2950685798-cpu/GestureCar/方案.md

# 手势操控小车 方案文档（V2）

> 2026-09-08 定稿。所有引脚、协议、手势定义以此文档为准。

## 1. 系统总览

```
手势端（手持裸板）                      车端（麦轮小车）
┌─────────────────────┐    NRF24L01   ┌──────────────────────────┐
│ STM32F103C8         │  50Hz 无线    │ STM32F103C8              │
│  ├─ MPU6500 (I2C2)  │ ◄───────────► │  ├─ NRF24L01 (软件SPI)      │
│  └─ NRF24L01 (软件SPI) │               │  ├─ 2×TB6612 (TIM2 PWM)  │
└─────────────────────┘               │  ├─ OLED (软件I2C)       │
                                      │  └─ 按键 PA15 (解锁/急停) │
                                      └──────────────────────────┘
```

- 工具链：STM32CubeMX + Keil MDK-ARM（两端均为 STM32F103C8）
- 电源：3S 锂电池 12V → 降压模块 5V → TB6612 VM + 蓝板 5V 脚（板上 AMS1117 出 3.3V），全部共地
  - 降压模块输出电流需 ≥2A（四轮堵转峰值 2~4A），实测确认
  - 电机额定 3-6V，**严禁 12V 直连 VM**

## 2. 车端引脚分配

| 引脚 | 功能 |
|---|---|
| PA0 | TIM2_CH1 PWM → 左 TB6612 PWMA（左前轮）  |
| PA1 | TIM2_CH2 PWM → 左 TB6612 PWMB（左后轮） |
| PA2 | TIM2_CH3 PWM → 右 TB6612 PWMA（右前轮） |
| PA3 | TIM2_CH4 PWM → 右 TB6612 PWMB（右后轮） |
| PB0 / PB1 | 左 TB6612 AIN1 / AIN2 |
| PB10 / PB11 | 左 TB6612 BIN1 / BIN2 |
| PB14 / PB15 | 右 TB6612 AIN1 / AIN2 |
| PB13 / PC15 | 右 TB6612 BIN1 / BIN2（2026-09-14 PB12 烧坏，BIN2 挪到 PC15） |
| PB8 / PB9 | OLED SCL / SDA（软件 I2C，从机地址 0x78） |
| PB6 / PB7 | 空闲（OLED 的 VCC 直接接 3.3V） |
| PA15 | 按键（内部上拉，按下接地） |
原引脚：| PA8 / PA9 / PA10 / PA11 / PA12 | NRF24L01 CE / SCK / CSN / MOSI / MISO（软件 SPI，与车端一致，IRQ 不接） |
| PA4 / PA5 / PA6 / PA7 / PA12 | NRF24L01 CE / CSN / SCK / MOSI / MISO（软件 SPI，GPIO 模拟；2026-09-13 PA8/PA9 烧坏后挪来，MISO 一直 PA12） |

- TB6612 STBY 直接接 3.3V 常使能
- TIM2 PWM：10kHz（PSC=0，ARR=7199）

## 3. 手势端引脚分配

| 引脚 | 功能 |
|---|---|
| PB10 / PB11 | MPU6500 I2C2 SCL / SDA（400kHz） |
| PA8 / PA9 / PA10 / PA11 / PA12 | NRF24L01 CE / SCK / CSN / MOSI / MISO（软件 SPI，与车端一致，IRQ 不接） |
| PB8 / PB9 | OLED 软 I2C SCL / SDA |
| PA0 | 按键（总开关）：一端接 3.3V、一端接引脚（内部下拉，按下=1）。按一下手端开始工作（采样+OLED 显示+NRF 发送），再按一下全部停止 |
| PA6 | 解锁/锁定车端的按键（接法和 PA0 相同：一端接 3.3V、内部下拉；按下连发命令 7，2026-09-14 加） |
| PA3 | 顺时针旋转指示输出（代码保留；2026-09-14 CubeMX 重生成后已不在配置里，需用时再配 GPIO_Output） |
| PC13 | 板载 LED（测试指示） |

- 不跑 DMP，直接读原始数据：加速度计反算 pitch/roll，陀螺仪 Z 轴角速度测拧腕
- 手端 OLED 只显示当前动作（2026-09-12 改：删掉 X/Y/Z/P/R 调试数字和标签，动作文字第 2 行居中；关机画面不变）。显示写入大幅减少，软 I2C 错位乱码概率随之大降

## 4. 手势定义

| 手势（手持板姿态） | 车端动作 | OLED 显示 |
|---|---|---|
| 前倾（pitch > +20°） | 前进（速度恒定） | `front` |
| 后倾（pitch < -20°） | 后退 | `back` |
| 左倾（roll > +20°） | 左平移 | `left` |
| 右倾（roll < -20°） | 右平移 | `right` |
| 左拧（yaw 角速度超阈值，正向） | 原地逆时针旋转 360° | `rotate left` |
| 右拧（yaw 角速度超阈值，负向） | 原地顺时针旋转 360° | `rotate right` |
| 放平（±20° 内） | 停止 | `stop` |
| 车端无信号（>500ms） | 先停车；持续失联 >2s 才重新锁定 | `link lost!` |

- 倾斜 ±20° 为死区阈值，速度恒定（PWM 占空比待实车标定）
- 旋转 360° 为**定时开环**：固定 PWM 转固定时间，时间常数实车标定；边沿触发，执行期间忽略重复指令
- 拧腕阈值（yaw 角速度）100°/s（2026-09-12 用户实测调整，陀螺仪原始值 ±13100）
- 旋转识别带 1 秒锁定：一次拧腕结束（角速度回到死区）后 1 秒内不再识别任何旋转，防止回正动作被误判成反向旋转（防连发）；锁定期内倾斜手势照常识别

## 5. 麦轮运动方向表（待实车验证）

"正"= 电机正转（车前进方向），"反"= 反转。平移方向依赖滚子朝向（A/B 轮），下表为通用形式，**实车测试后可能需交换平移的两行**，代码中做成常量表便于修改。

| 动作 | 左前 LF | 左后 LR | 右前 RF | 右后 RR |
|---|---|---|---|---|
| 前进 | 反 | 反 | 反 | 反 |
| 后退 | 正 | 正 | 正 | 正 |
| 左平移 | 正 | 反 | 反 | 正 |
| 右平移 | 反 | 正 | 正 | 反 |
| 顺时针原地转 | 反 | 反 | 正 | 正 |
| 逆时针原地转 | 正 | 正 | 反 | 反 |

> 2026-09-13 实测整车行进方向与手势相反（电机接线极性所致），平移四行已整体取反，上表为当前生效值；2026-09-13 晚实测原地旋转方向也反，旋转两行同样互换（顺时针/逆时针两行对调）。

## 6. 通信协议（NRF24L01）

```
帧格式: [帧头 0xA5] [命令] [序号] [校验]   共 4 字节
发送频率: 约 30Hz（60Hz 采样中每 2 拍发一包；2026-09-12 由 15Hz 提到 30Hz——
          电机 EMI 压接收时帧流越密，越容易漏进干扰间隙）
模式: 增强型 ShockBurst，自动应答 + 重发，2Mbps，固定 5 字节地址
```

命令字：

| 值 | 含义 |
|---|---|
| 0x00 | STOP（放平） |
| 0x01 | FRONT（前进） |
| 0x02 | BACK（后退） |
| 0x03 | LEFT（左平移） |
| 0x04 | RIGHT（右平移） |
| 0x05 | ROT_L（逆时针 360°） |
| 0x06 | ROT_R（顺时针 360°） |
| 0x07 | 解锁/锁定切换（手端 PA6 按下时连发约 400ms，车端按上升沿去重只切一次） |

- 序号每包递增（车端据此测丢包/判重）
- 校验 = 前 3 字节累加（已定）
- 旋转：手端识别后锁 1 秒防回正误触发；车端收到旋转命令时**边沿执行**一次 360°（转完丢弃积压旧帧，防连发）
- 失联保护（2026-09-12 改两级）：车端 500ms 收不到有效包 → 立即停车（安全第一）；停车后继续失联 2s → 才重新锁定（需再按键解锁）。电机 EMI 会压死车端 NRF 接收（车一停链路就恢复），旧逻辑「失联即锁」导致每个动作做 1 秒就被锁

## 7. 按键逻辑（车端 PA15）

```
上电: 锁定（不响应任何指令），OLED 显示 Locked
按下: 解锁 → Unlocked，开始响应指令
再按: 锁定 + 立即停车（兼作急停）
```

- 按键消抖 160ms（2026-09-12 由 20~30ms 加长：电机 EMI 会干扰按键线，短消抖易误触发），按一下切换一次
- 手端 PA6 遥控解锁/锁定（2026-09-14 加）：接法和 PA0 相同（一端 3.3V、内部下拉，按下读 1），消抖 48ms；按下后连发 0x07 约 400ms（≈12 帧，丢几帧也能送到），车端按 0x07 上升沿去重只切换一次，锁定期间也生效。车端 PA15 与手端 PA6 两个键等效，断联自动上锁后可用手端直接解锁

## 8. OLED 显示布局（128×64，8×16 英文，4 行）

```
行1: GestureCar V2
行2: Locked / Unlocked
行3~4: 当前指令（上表字符串），失联时显示 link lost!
```

- 复用现有软 I2C 驱动（OLED.c / OLED_Font.h，PB8/PB9，0x78），OLED_I2C_Init 中的重复 MX_GPIO_Init 调用删除

## 9. 待实车标定参数

| 参数 | 初值 | 说明 |
|---|---|---|
| 运行 PWM 占空比 | ~100%（999） | 2026-09-13 用户自行改 999；最早 1000 曾致 MCU 复位，若复位需降回 500 以下 |
| 360° 旋转时间 | 3000ms | 2026-09-13 用户要求改 3 秒；仍待实车标定 |
| 倾斜阈值 | ±20° | 已定 |
| 拧腕角速度阈值 | ±100°/s | 已定（2026-09-12） |
| 失联超时 | 停车 500ms / 上锁 2s | 已定（2026-09-12 改两级） |

## 10. 开发顺序

1. 车端电机驱动层（TB6612 + 麦轮方向表）+ 简单自检
2. 车端 OLED + 按键逻辑（Locked/Unlocked）
3. 车端 NRF 接收 + 协议解析 + 失联保护
4. 手势端 MPU6500 读取 + 手势识别 + NRF 发送
5. 整机联调 + 参数标定（占空比、360° 时间、拧腕阈值、麦轮平移方向）

---

# 第二部分：通俗版（新手向 · 原理 / 接线 / CubeMX 配置）

## 1. 这个车是怎么工作的（大白话）

手拿一块小电路板（手势端）：

- 板子**往前倾** → 车前进；**往后倾** → 车后退
- 板子**往左歪** → 车向左平移；**往右歪** → 车向右平移
- 板子**水平放平** → 车停
- 手拿板子**快速拧一下手腕** → 车原地转 360° 后停下

过程：手势板上的 **MPU6500**（姿态传感器）测出你的手势 → 板上的 **NRF24L01**（无线模块）把命令发给车 → 车上的 NRF 收到后，车上的 STM32 控制两块 **TB6612**（电机驱动芯片）让四个麦轮转起来。车上的 **OLED 屏幕**实时显示车正要执行的动作，**按键**是安全锁。

## 2. 车端：每个引脚接什么、CubeMX 里怎么配

### 2.1 已经配好的（现在工程里就有，不用动）

| 引脚 | 接到哪里 | CubeMX 里的配置 | 干什么用 |
|---|---|---|---|
| PA0 | 左 TB6612 的 PWMA | TIM2_CH1（PWM） | 左前轮转速 |
| PA1 | 左 TB6612 的 PWMB | TIM2_CH2（PWM） | 左后轮转速 |
| PA2 | 右 TB6612 的 PWMA | TIM2_CH3（PWM） | 右前轮转速 |
| PA3 | 右 TB6612 的 PWMB | TIM2_CH4（PWM） | 右后轮转速 |
| PB0 | 左 TB6612 的 AIN1 | GPIO_Output | 左前轮方向 |
| PB1 | 左 TB6612 的 AIN2 | GPIO_Output | 左前轮方向 |
| PB10 | 左 TB6612 的 BIN1 | GPIO_Output | 左后轮方向 |
| PB11 | 左 TB6612 的 BIN2 | GPIO_Output | 左后轮方向 |
| PB14 | 右 TB6612 的 AIN1 | GPIO_Output | 右前轮方向（2026-09-11 换接线后 PB12/13 与 PB14/15 职责互换） |
| PB15 | 右 TB6612 的 AIN2 | GPIO_Output | 右前轮方向 |
| PB13 | 右 TB6612 的 BIN1 | GPIO_Output | 右后轮方向 |
| PC15 | 右 TB6612 的 BIN2 | GPIO_Output | 右后轮方向（2026-09-14 PB12 烧坏挪来；PC15 原本就是 NRF 测试 LED 输出脚，无需重新生成） |
| PB8 | OLED 的 SCL | GPIO_Output | 屏幕时钟线（软件 I2C，普通输出脚即可） |
| PB9 | OLED 的 SDA | GPIO_Output | 屏幕数据线 |

> PWM 引脚解释：PWM 就是"超快地开开关关"，开的时间占比（占空比）越大，电机平均电压越高、转得越快。方向脚 AIN1/AIN2 决定正转还是反转，PWM 脚决定快慢。

### 2.2 需要你在 CubeMX 里新加的

| 引脚 | 接到哪里 | CubeMX 里的配置 | 说明 |
|---|---|---|---|
| （无） | OLED 模块的 VCC | 直接接 3.3V | OLED 供电直接接线，不占用引脚 |
| PA15 | 按键一端（另一端接 GND） | GPIO_Input + Pull-up | 上拉：不按读 1，按下读 0。注意 SYS 的 Debug 必须选 Serial Wire，PA15 才能当普通脚用 |
| PA10 | NRF 的 CSN | GPIO_Output | 无线模块片选（初始 High，不选中） |
| PA9 | NRF 的 SCK | GPIO_Output | 无线模块时钟 |
| PA12 | NRF 的 MISO | GPIO_Input + Pull-up | 无线模块收数据 |
| PA11 | NRF 的 MOSI | GPIO_Output | 无线模块发数据 |
| PA8 | NRF 的 CE | GPIO_Output | 无线模块使能（初始 Low） |

> NRF 采用软件 SPI（GPIO 模拟），5 个脚全配成 GPIO 即可，不需要开 SPI 外设。

## 3. 手势端：每个引脚接什么（另一块板子，引脚互不影响）

| 引脚 | 接到哪里 | CubeMX 里的配置 |
|---|---|---|
| PB10 | MPU6500 的 SCL | I2C2_SCL |
| PB11 | MPU6500 的 SDA | I2C2_SDA |
| PA10 | NRF 的 CSN | GPIO_Output |
| PA9 | NRF 的 SCK | GPIO_Output |
| PA12 | NRF 的 MISO | GPIO_Input + Pull-up |
| PA11 | NRF 的 MOSI | GPIO_Output |
| PA8 | NRF 的 CE | GPIO_Output |
| 5V 脚 | 供电 | 接 5V（USB 充电宝 / 电池 + 降压模块） |

## 4. 实物接线（照着连就行）

### 4.1 电源

```
3S锂电池(12V) → 降压模块(调到5V输出) ──┬── 蓝板"5V"脚（板上自动稳压出3.3V）
                                      └── 两块 TB6612 的 VM 脚
降压模块的 GND ─────────────── 所有模块的 GND 都连在一起（共地！）
```

⚠️ **共地是必须的**：电池、降压模块、蓝板、两块 TB6612、OLED、NRF 的 GND 全部相通，不然信号对不上、车会抽风。
⚠️ **电机额定 3~6V**：降压模块必须调到 5V 再接 TB6612 的 VM，**严禁 12V 直接接 VM**。
⚠️ 降压模块电流要 ≥2A（四个轮子一起堵转时电流很大）。

### 4.2 两块 TB6612（模块上的引脚含义）

每个 TB6612 模块有一面信号脚、一面输出脚：

| 模块引脚 | 含义 | 接到哪（左模块 / 右模块） |
|---|---|---|
| PWMA | A 路转速（PWM） | PA0 / PA2 |
| AIN1、AIN2 | A 路方向 | PB0、PB1 / PB14、PB15 |
| PWMB | B 路转速（PWM） | PA1 / PA3 |
| BIN1、BIN2 | B 路方向 | PB10、PB11 / PB13、PC15 |
| STBY | 使能脚，高电平才工作 | 直接接 3.3V（常开） |
| VM | 电机电源 | 降压模块 5V |
| VCC | 芯片逻辑电源 | 3.3V |
| GND | 地 | 共地 |
| AO1、AO2 | 接 A 路电机两根线 | 左模块接**左前轮**电机 / 右模块接**右前轮** |
| BO1、BO2 | 接 B 路电机两根线 | 左模块接**左后轮**电机 / 右模块接**右后轮** |

控制逻辑（真值表，程序里就是按这个写）：

| AIN1 | AIN2 | 电机 |
|---|---|---|
| 0 | 0 | 停（自由滑行） |
| 1 | 0 | 正转 |
| 0 | 1 | 反转 |
| 1 | 1 | 刹车（急停，推荐停车用这个） |

> 电机两根线接反了不会坏，只是这个轮子方向反了——交换两根线即可。

### 4.3 OLED 四脚模块

| OLED 引脚 | 接到哪 |
|---|---|
| VCC | 直接接 3.3V |
| GND | 共地 |
| SCL | PB8 |
| SDA | PB9 |

### 4.4 NRF24L01 模块（8 脚，两端接法相同）

| NRF 引脚 | 接到哪 |
|---|---|
| VCC | **3.3V（必须！接 5V 会烧）** |
| GND | 共地 |
| CE | PA8 |
| CSN | PA10 |
| SCK | PA9 |
| MOSI | PA11 |
| MISO | PA12 |
| IRQ | 悬空不接 |

### 4.5 按键（车端）

PA15 接按键一脚，按键另一脚接 GND。不按 = 读到 1，按下 = 读到 0。

### 4.6 MPU6500 模块（手势端）

| MPU6500 模块引脚 | 接到哪 |
|---|---|
| VCC | 蓝板 **3.3V** 脚（GY-6500 板载稳压才允许接 5V，拿不准统一接 3.3V） |
| GND | 共地 |
| SCL | PB10（I2C2_SCL） |
| SDA | PB11（I2C2_SDA） |
| AD0（地址选择） | 接 GND = I2C 地址 0x68（只用一颗就接地） |
| INT（中断输出） | 悬空不接（程序轮询读数据，不用中断） |

限制/注意：

1. 芯片 VDD 上限 3.6V，**不能直接接 5V**；模块板载稳压的才允许 VCC 接 5V，拿不准就接 3.3V
2. SCL/SDA 要上拉：模块板一般自带 4.7k 上拉，CubeMX 配 I2C2 时引脚也会开内部上拉，短线够用；通信不稳再外接 4.7k 到 3.3V
3. I2C 速率配 400kHz（MPU6500 最高 400kHz），杜邦线尽量短
4. 上电后等约 100ms 再读 WHO_AM_I（寄存器 0x75，应返回 0x70），不对就是接线/地址/供电问题
5. PB10/PB11 是 5V 容忍脚，模块上拉是 5V 也不会烧板子，但统一 3.3V 最好
6. 手势端供电：蓝板 5V 脚接 USB 充电宝，板上稳压出 3.3V 同时喂 MPU6500（~4mA）和 NRF（峰值 ~13mA），够用

## 5. CubeMX 关键配置说明（车端）

1. **RCC**：HSE 选 Crystal/Ceramic Resonator，时钟树 PLL×9 → 系统时钟 72MHz
2. **SYS**：Debug 选 **Serial Wire**（不选 JTAG，PA15 才能当按键用）
3. **TIM2**：Clock Source 选 Internal Clock，Channel1~4 全部选 PWM Generation CHx；PSC=0、ARR=7199 → 频率 = 72MHz ÷ 7200 = **10kHz**；Pulse 先填 0（上电时电机不动，安全）
   - 为什么 10kHz：PWM 频率低于 1kHz 时电机会发出"滋滋"声，10kHz 人耳听不见
4. **GPIO 输出**：PB0、PB1、PB10~PB15、PB8、PB9 全部 Output Push-Pull
5. **GPIO 输入**：PA15 设 Input + Pull-up

## 6. 手势是怎么测出来的（通俗版）

- MPU6500 里有两个传感器：**加速度计**（测倾斜——重力方向随板子倾斜而变，算出 pitch/roll 两个角）和**陀螺仪**（测角速度——转多快）
- 前/后倾、左/右倾看加速度计的 pitch/roll；**拧手腕**看陀螺仪 Z 轴的角速度（拧得越快数值越大）
- ±20° 是"死区"：倾斜不够 20° 就认为没做手势，这样手轻微抖不会误触发
- 只有"拧腕"是触发式（拧一下 → 车转 360° 就停），其他手势是"保持式"（一直倾斜就一直走，放平就停）

## 7. 常见坑（先看一遍，少走弯路）

1. NRF 接 5V 必烧，只能 3.3V
2. 忘了共地 → 各种玄学问题
3. OLED 不亮：检查 VCC 是否接了 3.3V、SCL/SDA 是否接反（SCL 必须接 PB8）
4. **TB6612 的 VM 误接 12V（实测故障，2026-09-12）**：电机额定 3-6V，12V 灌入瞬间电流暴涨 → 电池电压被拉垮 → 降压模块输出掉 → 车端 3.3V 不稳 → NRF/蓝板复位。表现为"车一执行动作，OLED 就跳回 LOCKED/STOP，电机也不转"。VM 必须接降压模块 5V 输出
5. 电机不转：检查 TB6612 的 STBY 有没有接 3.3V、VM 有没有接 5V
6. 下载程序：ST-Link 接蓝板的 3.3V、SWDIO（PA13）、SWCLK（PA14）、GND
7. 第一次测试时**把车架空**（轮子悬空），防止车突然窜出去
