2950685798-cpu/GestureCar/相关资料/43c3239f1538416598892b294f0051db.png

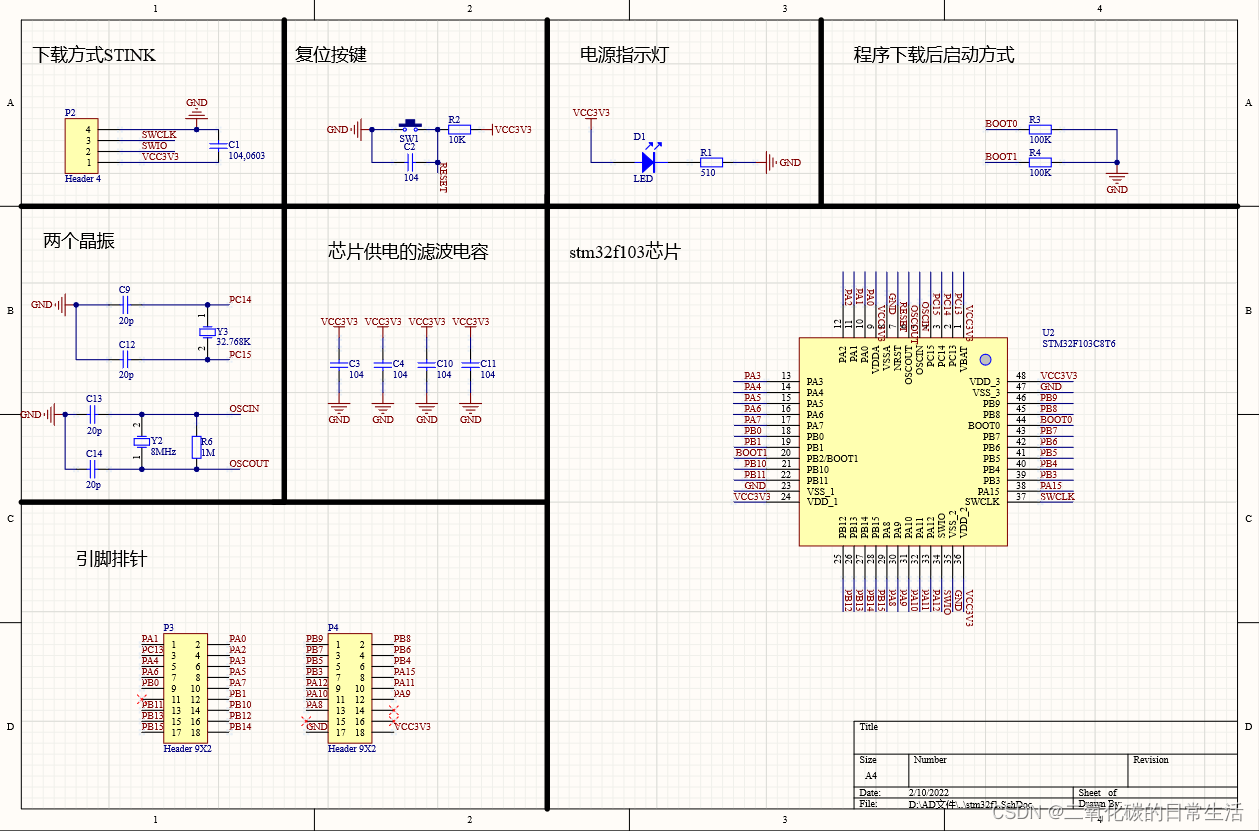
相关资料/43c3239f1538416598892b294f0051db.png
