2950685798-cpu/GestureCar/相关资料/268924_TB6612FNG.png

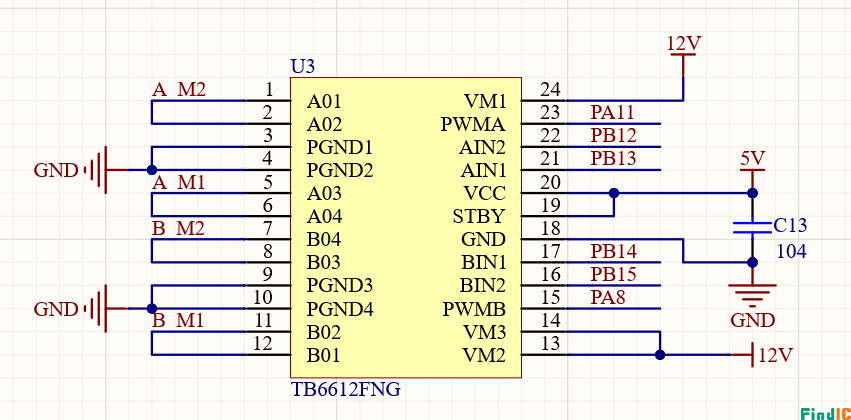
相关资料/268924_TB6612FNG.png
