2950685798-cpu/GestureCar/Car/MDK-ARM/.cmsis/device/ARM/ARMCM85/Include/Template/partition_ARMCM85.h

/**************************************************************************//**
 * @file     partition_ARMCM85.h
 * @brief    CMSIS-CORE Initial Setup for Secure / Non-Secure Zones for Armv8.1-M Mainline
 * @version  V1.0.0
 * @date     07. March 2022
 ******************************************************************************/
/*
 * Copyright (c) 2022 Arm Limited. All rights reserved.
 *
 * SPDX-License-Identifier: Apache-2.0
 *
 * Licensed under the Apache License, Version 2.0 (the License); you may
 * not use this file except in compliance with the License.
 * You may obtain a copy of the License at
 *
 * www.apache.org/licenses/LICENSE-2.0
 *
 * Unless required by applicable law or agreed to in writing, software
 * distributed under the License is distributed on an AS IS BASIS, WITHOUT
 * WARRANTIES OR CONDITIONS OF ANY KIND, either express or implied.
 * See the License for the specific language governing permissions and
 * limitations under the License.
 */

#ifndef PARTITION_ARMCM85_H
#define PARTITION_ARMCM85_H

/*
//-------- <<< Use Configuration Wizard in Context Menu >>> -----------------
*/

/*
// <e>Initialize Security Attribution Unit (SAU) CTRL register
*/
#define SAU_INIT_CTRL          1

/*
//   <q> Enable SAU
//   <i> Value for SAU->CTRL register bit ENABLE
*/
#define SAU_INIT_CTRL_ENABLE   1

/*
//   <o> When SAU is disabled
//     <0=> All Memory is Secure
//     <1=> All Memory is Non-Secure
//   <i> Value for SAU->CTRL register bit ALLNS
//   <i> When all Memory is Non-Secure (ALLNS is 1), IDAU can override memory map configuration.
*/
#define SAU_INIT_CTRL_ALLNS  0

/*
// </e>
*/

/*
// <h>Initialize Security Attribution Unit (SAU) Address Regions
// <i>SAU configuration specifies regions to be one of:
// <i> - Secure and Non-Secure Callable
// <i> - Non-Secure
// <i>Note: All memory regions not configured by SAU are Secure
*/
#define SAU_REGIONS_MAX   8                 /* Max. number of SAU regions */

/*
//   <e>Initialize SAU Region 0
//   <i> Setup SAU Region 0 memory attributes
*/
#define SAU_INIT_REGION0    1

/*
//     <s>Description
*/
#define SAU_INIT_DSCR0     "NSC code"   /* description SAU region 0 */

/*
//     <o>Start Address <0-0xFFFFFFE0>
*/
#define SAU_INIT_START0     0x00000000      /* start address of SAU region 0 */

/*
//     <o>End Address <0x1F-0xFFFFFFFF>
*/
#define SAU_INIT_END0       0x001FFFFF      /* end address of SAU region 0 */

/*
//     <o>Region is
//         <0=>Non-Secure
//         <1=>Secure, Non-Secure Callable
*/
#define SAU_INIT_NSC0       1
/*
//   </e>
*/

/*
//   <e>Initialize SAU Region 1
//   <i> Setup SAU Region 1 memory attributes
*/
#define SAU_INIT_REGION1    1

/*
//     <s>Description
*/
#define SAU_INIT_DSCR1     "NS code"   /* description SAU region 1 */

/*
//     <o>Start Address <0-0xFFFFFFE0>
*/
#define SAU_INIT_START1     0x00200000

/*
//     <o>End Address <0x1F-0xFFFFFFFF>
*/
#define SAU_INIT_END1       0x003FFFFF

/*
//     <o>Region is
//         <0=>Non-Secure
//         <1=>Secure, Non-Secure Callable
*/
#define SAU_INIT_NSC1       0
/*
//   </e>
*/

/*
//   <e>Initialize SAU Region 2
//   <i> Setup SAU Region 2 memory attributes
*/
#define SAU_INIT_REGION2    1

/*
//     <s>Description
*/
#define SAU_INIT_DSCR2     "NS data"   /* description SAU region 2 */

/*
//     <o>Start Address <0-0xFFFFFFE0>
*/
#define SAU_INIT_START2     0x20200000

/*
//     <o>End Address <0x1F-0xFFFFFFFF>
*/
#define SAU_INIT_END2       0x203FFFFF

/*
//     <o>Region is
//         <0=>Non-Secure
//         <1=>Secure, Non-Secure Callable
*/
#define SAU_INIT_NSC2       0
/*
//   </e>
*/

/*
//   <e>Initialize SAU Region 3
//   <i> Setup SAU Region 3 memory attributes
*/
#define SAU_INIT_REGION3    1

/*
//     <s>Description
*/
#define SAU_INIT_DSCR3     "NS peripherals"   /* description SAU region 3 */

/*
//     <o>Start Address <0-0xFFFFFFE0>
*/
#define SAU_INIT_START3     0x40000000

/*
//     <o>End Address <0x1F-0xFFFFFFFF>
*/
#define SAU_INIT_END3       0x40040000

/*
//     <o>Region is
//         <0=>Non-Secure
//         <1=>Secure, Non-Secure Callable
*/
#define SAU_INIT_NSC3       0
/*
//   </e>
*/

/*
//   <e>Initialize SAU Region 4
//   <i> Setup SAU Region 4 memory attributes
*/
#define SAU_INIT_REGION4    0

/*
//     <s>Description
*/
#define SAU_INIT_DSCR4     "SAU region 4"   /* description SAU region 4 */

/*
//     <o>Start Address <0-0xFFFFFFE0>
*/
#define SAU_INIT_START4     0x00000000      /* start address of SAU region 4 */

/*
//     <o>End Address <0x1F-0xFFFFFFFF>
*/
#define SAU_INIT_END4       0x00000000      /* end address of SAU region 4 */

/*
//     <o>Region is
//         <0=>Non-Secure
//         <1=>Secure, Non-Secure Callable
*/
#define SAU_INIT_NSC4       0
/*
//   </e>
*/

/*
//   <e>Initialize SAU Region 5
//   <i> Setup SAU Region 5 memory attributes
*/
#define SAU_INIT_REGION5    0

/*
//     <s>Description
*/
#define SAU_INIT_DSCR5     "SAU region 5"   /* description SAU region 5 */

/*
//     <o>Start Address <0-0xFFFFFFE0>
*/
#define SAU_INIT_START5     0x00000000

/*
//     <o>End Address <0x1F-0xFFFFFFFF>
*/
#define SAU_INIT_END5       0x00000000

/*
//     <o>Region is
//         <0=>Non-Secure
//         <1=>Secure, Non-Secure Callable
*/
#define SAU_INIT_NSC5       0
/*
//   </e>
*/

/*
//   <e>Initialize SAU Region 6
//   <i> Setup SAU Region 6 memory attributes
*/
#define SAU_INIT_REGION6    0

/*
//     <s>Description
*/
#define SAU_INIT_DSCR6     "SAU region 6"   /* description SAU region 6 */

/*
//     <o>Start Address <0-0xFFFFFFE0>
*/
#define SAU_INIT_START6     0x00000000

/*
//     <o>End Address <0x1F-0xFFFFFFFF>
*/
#define SAU_INIT_END6       0x00000000

/*
//     <o>Region is
//         <0=>Non-Secure
//         <1=>Secure, Non-Secure Callable
*/
#define SAU_INIT_NSC6       0
/*
//   </e>
*/

/*
//   <e>Initialize SAU Region 7
//   <i> Setup SAU Region 7 memory attributes
*/
#define SAU_INIT_REGION7    0

/*
//     <s>Description
*/
#define SAU_INIT_DSCR7     "SAU region 7"   /* description SAU region 7 */

/*
//     <o>Start Address <0-0xFFFFFFE0>
*/
#define SAU_INIT_START7     0x00000000

/*
//     <o>End Address <0x1F-0xFFFFFFFF>
*/
#define SAU_INIT_END7       0x00000000

/*
//     <o>Region is
//         <0=>Non-Secure
//         <1=>Secure, Non-Secure Callable
*/
#define SAU_INIT_NSC7       0
/*
//   </e>
*/

/*
// </h>
*/

/*
// <e>Setup behaviour of Sleep and Exception Handling
*/
#define SCB_CSR_AIRCR_INIT  1

/*
//   <o> Deep Sleep can be enabled by
//     <0=>Secure and Non-Secure state
//     <1=>Secure state only
//   <i> Value for SCB->CSR register bit DEEPSLEEPS
*/
#define SCB_CSR_DEEPSLEEPS_VAL  1

/*
//   <o>System reset request accessible from
//     <0=> Secure and Non-Secure state
//     <1=> Secure state only
//   <i> Value for SCB->AIRCR register bit SYSRESETREQS
*/
#define SCB_AIRCR_SYSRESETREQS_VAL  1

/*
//   <o>Priority of Non-Secure exceptions is
//     <0=> Not altered
//     <1=> Lowered to 0x80-0xFF
//   <i> Value for SCB->AIRCR register bit PRIS
*/
#define SCB_AIRCR_PRIS_VAL      1

/*
//   <o>BusFault, HardFault, and NMI target
//     <0=> Secure state
//     <1=> Non-Secure state
//   <i> Value for SCB->AIRCR register bit BFHFNMINS
*/
#define SCB_AIRCR_BFHFNMINS_VAL 0

/*
// </e>
*/

/*
// <e>Setup behaviour of Floating Point and Vector Unit (FPU/MVE)
*/
#define TZ_FPU_NS_USAGE 1

/*
// <o>Floating Point and Vector Unit usage
//     <0=> Secure state only
//     <3=> Secure and Non-Secure state
//   <i> Value for SCB->NSACR register bits CP10, CP11
*/
#define SCB_NSACR_CP10_11_VAL       3

/*
// <o>Treat floating-point registers as Secure
//     <0=> Disabled
//     <1=> Enabled
//   <i> Value for FPU->FPCCR register bit TS
*/
#define FPU_FPCCR_TS_VAL            0

/*
// <o>Clear on return (CLRONRET) accessibility
//     <0=> Secure and Non-Secure state
//     <1=> Secure state only
//   <i> Value for FPU->FPCCR register bit CLRONRETS
*/
#define FPU_FPCCR_CLRONRETS_VAL     0

/*
// <o>Clear floating-point caller saved registers on exception return
//     <0=> Disabled
//     <1=> Enabled
//   <i> Value for FPU->FPCCR register bit CLRONRET
*/
#define FPU_FPCCR_CLRONRET_VAL      1

/*
// </e>
*/

/*
// <h>Setup Interrupt Target
*/

/*
//   <e>Initialize ITNS 0 (Interrupts 0..31)
*/
#define NVIC_INIT_ITNS0    1

/*
// Interrupts 0..31
//   <o.0>  Interrupt 0   <0=> Secure state <1=> Non-Secure state
//   <o.1>  Interrupt 1   <0=> Secure state <1=> Non-Secure state
//   <o.2>  Interrupt 2   <0=> Secure state <1=> Non-Secure state
//   <o.3>  Interrupt 3   <0=> Secure state <1=> Non-Secure state
//   <o.4>  Interrupt 4   <0=> Secure state <1=> Non-Secure state
//   <o.5>  Interrupt 5   <0=> Secure state <1=> Non-Secure state
//   <o.6>  Interrupt 6   <0=> Secure state <1=> Non-Secure state
//   <o.7>  Interrupt 7   <0=> Secure state <1=> Non-Secure state
//   <o.8>  Interrupt 8   <0=> Secure state <1=> Non-Secure state
//   <o.9>  Interrupt 9   <0=> Secure state <1=> Non-Secure state
//   <o.10> Interrupt 10  <0=> Secure state <1=> Non-Secure state
//   <o.11> Interrupt 11  <0=> Secure state <1=> Non-Secure state
//   <o.12> Interrupt 12  <0=> Secure state <1=> Non-Secure state
//   <o.13> Interrupt 13  <0=> Secure state <1=> Non-Secure state
//   <o.14> Interrupt 14  <0=> Secure state <1=> Non-Secure state
//   <o.15> Interrupt 15  <0=> Secure state <1=> Non-Secure state
//   <o.16> Interrupt 16  <0=> Secure state <1=> Non-Secure state
//   <o.17> Interrupt 17  <0=> Secure state <1=> Non-Secure state
//   <o.18> Interrupt 18  <0=> Secure state <1=> Non-Secure state
//   <o.19> Interrupt 19  <0=> Secure state <1=> Non-Secure state
//   <o.20> Interrupt 20  <0=> Secure state <1=> Non-Secure state
//   <o.21> Interrupt 21  <0=> Secure state <1=> Non-Secure state
//   <o.22> Interrupt 22  <0=> Secure state <1=> Non-Secure state
//   <o.23> Interrupt 23  <0=> Secure state <1=> Non-Secure state
//   <o.24> Interrupt 24  <0=> Secure state <1=> Non-Secure state
//   <o.25> Interrupt 25  <0=> Secure state <1=> Non-Secure state
//   <o.26> Interrupt 26  <0=> Secure state <1=> Non-Secure state
//   <o.27> Interrupt 27  <0=> Secure state <1=> Non-Secure state
//   <o.28> Interrupt 28  <0=> Secure state <1=> Non-Secure state
//   <o.29> Interrupt 29  <0=> Secure state <1=> Non-Secure state
//   <o.30> Interrupt 30  <0=> Secure state <1=> Non-Secure state
//   <o.31> Interrupt 31  <0=> Secure state <1=> Non-Secure state
*/
#define NVIC_INIT_ITNS0_VAL      0x00000000

/*
//   </e>
*/

/*
//   <e>Initialize ITNS 1 (Interrupts 32..63)
*/
#define NVIC_INIT_ITNS1    1

/*
// Interrupts 32..63
//   <o.0>  Interrupt 32  <0=> Secure state <1=> Non-Secure state
//   <o.1>  Interrupt 33  <0=> Secure state <1=> Non-Secure state
//   <o.2>  Interrupt 34  <0=> Secure state <1=> Non-Secure state
//   <o.3>  Interrupt 35  <0=> Secure state <1=> Non-Secure state
//   <o.4>  Interrupt 36  <0=> Secure state <1=> Non-Secure state
//   <o.5>  Interrupt 37  <0=> Secure state <1=> Non-Secure state
//   <o.6>  Interrupt 38  <0=> Secure state <1=> Non-Secure state
//   <o.7>  Interrupt 39  <0=> Secure state <1=> Non-Secure state
//   <o.8>  Interrupt 40  <0=> Secure state <1=> Non-Secure state
//   <o.9>  Interrupt 41  <0=> Secure state <1=> Non-Secure state
//   <o.10> Interrupt 42  <0=> Secure state <1=> Non-Secure state
//   <o.11> Interrupt 43  <0=> Secure state <1=> Non-Secure state
//   <o.12> Interrupt 44  <0=> Secure state <1=> Non-Secure state
//   <o.13> Interrupt 45  <0=> Secure state <1=> Non-Secure state
//   <o.14> Interrupt 46  <0=> Secure state <1=> Non-Secure state
//   <o.15> Interrupt 47  <0=> Secure state <1=> Non-Secure state
//   <o.16> Interrupt 48  <0=> Secure state <1=> Non-Secure state
//   <o.17> Interrupt 49  <0=> Secure state <1=> Non-Secure state
//   <o.18> Interrupt 50  <0=> Secure state <1=> Non-Secure state
//   <o.19> Interrupt 51  <0=> Secure state <1=> Non-Secure state
//   <o.20> Interrupt 52  <0=> Secure state <1=> Non-Secure state
//   <o.21> Interrupt 53  <0=> Secure state <1=> Non-Secure state
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
//   <o.30> Interrupt 478 <0=> Secure state <1=> Non-Secure state
//   <o.31> Interrupt 479 <0=> Secure state <1=> Non-Secure state
*/
#define NVIC_INIT_ITNS14_VAL     0x00000000

/*
//   </e>
*/

/*
//   <e>Initialize ITNS 15 (Interrupts 480..511)
*/
#define NVIC_INIT_ITNS15   0

/*
// Interrupts 480..511
//   <o.0>  Interrupt 480 <0=> Secure state <1=> Non-Secure state
//   <o.1>  Interrupt 481 <0=> Secure state <1=> Non-Secure state
//   <o.2>  Interrupt 482 <0=> Secure state <1=> Non-Secure state
//   <o.3>  Interrupt 483 <0=> Secure state <1=> Non-Secure state
//   <o.4>  Interrupt 484 <0=> Secure state <1=> Non-Secure state
//   <o.5>  Interrupt 485 <0=> Secure state <1=> Non-Secure state
//   <o.6>  Interrupt 486 <0=> Secure state <1=> Non-Secure state
//   <o.7>  Interrupt 487 <0=> Secure state <1=> Non-Secure state
//   <o.8>  Interrupt 488 <0=> Secure state <1=> Non-Secure state
//   <o.9>  Interrupt 489 <0=> Secure state <1=> Non-Secure state
//   <o.10> Interrupt 490 <0=> Secure state <1=> Non-Secure state
//   <o.11> Interrupt 491 <0=> Secure state <1=> Non-Secure state
//   <o.12> Interrupt 492 <0=> Secure state <1=> Non-Secure state
//   <o.13> Interrupt 493 <0=> Secure state <1=> Non-Secure state
//   <o.14> Interrupt 494 <0=> Secure state <1=> Non-Secure state
//   <o.15> Interrupt 495 <0=> Secure state <1=> Non-Secure state
//   <o.16> Interrupt 496 <0=> Secure state <1=> Non-Secure state
//   <o.17> Interrupt 497 <0=> Secure state <1=> Non-Secure state
//   <o.18> Interrupt 498 <0=> Secure state <1=> Non-Secure state
//   <o.19> Interrupt 499 <0=> Secure state <1=> Non-Secure state
//   <o.20> Interrupt 500 <0=> Secure state <1=> Non-Secure state
//   <o.21> Interrupt 501 <0=> Secure state <1=> Non-Secure state
//   <o.22> Interrupt 502 <0=> Secure state <1=> Non-Secure state
//   <o.23> Interrupt 503 <0=> Secure state <1=> Non-Secure state
//   <o.24> Interrupt 504 <0=> Secure state <1=> Non-Secure state
//   <o.25> Interrupt 505 <0=> Secure state <1=> Non-Secure state
//   <o.26> Interrupt 506 <0=> Secure state <1=> Non-Secure state
//   <o.27> Interrupt 507 <0=> Secure state <1=> Non-Secure state
//   <o.28> Interrupt 508 <0=> Secure state <1=> Non-Secure state
//   <o.29> Interrupt 509 <0=> Secure state <1=> Non-Secure state
//   <o.30> Interrupt 510 <0=> Secure state <1=> Non-Secure state
//   <o.31> Interrupt 511 <0=> Secure state <1=> Non-Secure state
*/
#define NVIC_INIT_ITNS15_VAL     0x00000000

/*
//   </e>
*/

/*
// </h>
*/



/*
    max 128 SAU regions.
    SAU regions are defined in partition.h
 */

#define SAU_INIT_REGION(n) \
    SAU->RNR  =  (n                                     & SAU_RNR_REGION_Msk); \
    SAU->RBAR =  (SAU_INIT_START##n                     & SAU_RBAR_BADDR_Msk); \
    SAU->RLAR =  (SAU_INIT_END##n                       & SAU_RLAR_LADDR_Msk) | \
                ((SAU_INIT_NSC##n << SAU_RLAR_NSC_Pos)  & SAU_RLAR_NSC_Msk)   | 1U

/**
  \brief   Setup a SAU Region
  \details Writes the region information contained in SAU_Region to the
           registers SAU_RNR, SAU_RBAR, and SAU_RLAR
 */
__STATIC_INLINE void TZ_SAU_Setup (void)
{

#if defined (__SAUREGION_PRESENT) && (__SAUREGION_PRESENT == 1U)

  #if defined (SAU_INIT_REGION0) && (SAU_INIT_REGION0 == 1U)
    SAU_INIT_REGION(0);
  #endif

  #if defined (SAU_INIT_REGION1) && (SAU_INIT_REGION1 == 1U)
    SAU_INIT_REGION(1);
  #endif

  #if defined (SAU_INIT_REGION2) && (SAU_INIT_REGION2 == 1U)
    SAU_INIT_REGION(2);
  #endif

  #if defined (SAU_INIT_REGION3) && (SAU_INIT_REGION3 == 1U)
    SAU_INIT_REGION(3);
  #endif

  #if defined (SAU_INIT_REGION4) && (SAU_INIT_REGION4 == 1U)
    SAU_INIT_REGION(4);
  #endif

  #if defined (SAU_INIT_REGION5) && (SAU_INIT_REGION5 == 1U)
    SAU_INIT_REGION(5);
  #endif

  #if defined (SAU_INIT_REGION6) && (SAU_INIT_REGION6 == 1U)
    SAU_INIT_REGION(6);
  #endif

  #if defined (SAU_INIT_REGION7) && (SAU_INIT_REGION7 == 1U)
    SAU_INIT_REGION(7);
  #endif

  /* repeat this for all possible SAU regions */

#endif /* defined (__SAUREGION_PRESENT) && (__SAUREGION_PRESENT == 1U) */


  #if defined (SAU_INIT_CTRL) && (SAU_INIT_CTRL == 1U)
    SAU->CTRL = ((SAU_INIT_CTRL_ENABLE << SAU_CTRL_ENABLE_Pos) & SAU_CTRL_ENABLE_Msk) |
                ((SAU_INIT_CTRL_ALLNS  << SAU_CTRL_ALLNS_Pos)  & SAU_CTRL_ALLNS_Msk)   ;
  #endif

  #if defined (SCB_CSR_AIRCR_INIT) && (SCB_CSR_AIRCR_INIT == 1U)
    SCB->SCR   = (SCB->SCR   & ~(SCB_SCR_SLEEPDEEPS_Msk    )) |
                   ((SCB_CSR_DEEPSLEEPS_VAL     << SCB_SCR_SLEEPDEEPS_Pos)     & SCB_SCR_SLEEPDEEPS_Msk);

    SCB->AIRCR = (SCB->AIRCR & ~(SCB_AIRCR_VECTKEY_Msk   | SCB_AIRCR_SYSRESETREQS_Msk |
                                 SCB_AIRCR_BFHFNMINS_Msk | SCB_AIRCR_PRIS_Msk          ))                    |
                   ((0x05FAU                    << SCB_AIRCR_VECTKEY_Pos)      & SCB_AIRCR_VECTKEY_Msk)      |
                   ((SCB_AIRCR_SYSRESETREQS_VAL << SCB_AIRCR_SYSRESETREQS_Pos) & SCB_AIRCR_SYSRESETREQS_Msk) |
                   ((SCB_AIRCR_PRIS_VAL         << SCB_AIRCR_PRIS_Pos)         & SCB_AIRCR_PRIS_Msk)         |
                   ((SCB_AIRCR_BFHFNMINS_VAL    << SCB_AIRCR_BFHFNMINS_Pos)    & SCB_AIRCR_BFHFNMINS_Msk);
  #endif /* defined (SCB_CSR_AIRCR_INIT) && (SCB_CSR_AIRCR_INIT == 1U) */

  #if (((defined (__FPU_USED) && (__FPU_USED == 1U))              || \
        (defined (__ARM_FEATURE_MVE) && (__ARM_FEATURE_MVE > 0))) && \
       (defined (TZ_FPU_NS_USAGE) && (TZ_FPU_NS_USAGE == 1U)))

    SCB->NSACR = (SCB->NSACR & ~(SCB_NSACR_CP10_Msk | SCB_NSACR_CP11_Msk)) |
                   ((SCB_NSACR_CP10_11_VAL << SCB_NSACR_CP10_Pos) & (SCB_NSACR_CP10_Msk | SCB_NSACR_CP11_Msk));

    FPU->FPCCR = (FPU->FPCCR & ~(FPU_FPCCR_TS_Msk | FPU_FPCCR_CLRONRETS_Msk | FPU_FPCCR_CLRONRET_Msk)) |
                   ((FPU_FPCCR_TS_VAL        << FPU_FPCCR_TS_Pos       ) & FPU_FPCCR_TS_Msk       ) |
                   ((FPU_FPCCR_CLRONRETS_VAL << FPU_FPCCR_CLRONRETS_Pos) & FPU_FPCCR_CLRONRETS_Msk) |
                   ((FPU_FPCCR_CLRONRET_VAL  << FPU_FPCCR_CLRONRET_Pos ) & FPU_FPCCR_CLRONRET_Msk );
  #endif

  #if defined (NVIC_INIT_ITNS0) && (NVIC_INIT_ITNS0 == 1U)
    NVIC->ITNS[0] = NVIC_INIT_ITNS0_VAL;
  #endif

  #if defined (NVIC_INIT_ITNS1) && (NVIC_INIT_ITNS1 == 1U)
    NVIC->ITNS[1] = NVIC_INIT_ITNS1_VAL;
  #endif

  #if defined (NVIC_INIT_ITNS2) && (NVIC_INIT_ITNS2 == 1U)
    NVIC->ITNS[2] = NVIC_INIT_ITNS2_VAL;
  #endif

  #if defined (NVIC_INIT_ITNS3) && (NVIC_INIT_ITNS3 == 1U)
    NVIC->ITNS[3] = NVIC_INIT_ITNS3_VAL;
  #endif

  #if defined (NVIC_INIT_ITNS4) && (NVIC_INIT_ITNS4 == 1U)
    NVIC->ITNS[4] = NVIC_INIT_ITNS4_VAL;
  #endif

  #if defined (NVIC_INIT_ITNS5) && (NVIC_INIT_ITNS5 == 1U)
    NVIC->ITNS[5] = NVIC_INIT_ITNS5_VAL;
  #endif

  #if defined (NVIC_INIT_ITNS6) && (NVIC_INIT_ITNS6 == 1U)
    NVIC->ITNS[6] = NVIC_INIT_ITNS6_VAL;
  #endif

  #if defined (NVIC_INIT_ITNS7) && (NVIC_INIT_ITNS7 == 1U)
    NVIC->ITNS[7] = NVIC_INIT_ITNS7_VAL;
  #endif

  #if defined (NVIC_INIT_ITNS8) && (NVIC_INIT_ITNS8 == 1U)
    NVIC->ITNS[8] = NVIC_INIT_ITNS8_VAL;
  #endif

  #if defined (NVIC_INIT_ITNS9) && (NVIC_INIT_ITNS9 == 1U)
    NVIC->ITNS[9] = NVIC_INIT_ITNS9_VAL;
  #endif

  #if defined (NVIC_INIT_ITNS10) && (NVIC_INIT_ITNS10 == 1U)
    NVIC->ITNS[10] = NVIC_INIT_ITNS10_VAL;
  #endif

  #if defined (NVIC_INIT_ITNS11) && (NVIC_INIT_ITNS11 == 1U)
    NVIC->ITNS[11] = NVIC_INIT_ITNS11_VAL;
  #endif

  #if defined (NVIC_INIT_ITNS12) && (NVIC_INIT_ITNS12 == 1U)
    NVIC->ITNS[12] = NVIC_INIT_ITNS12_VAL;
  #endif

  #if defined (NVIC_INIT_ITNS13) && (NVIC_INIT_ITNS13 == 1U)
    NVIC->ITNS[13] = NVIC_INIT_ITNS13_VAL;
  #endif

  #if defined (NVIC_INIT_ITNS14) && (NVIC_INIT_ITNS14 == 1U)
    NVIC->ITNS[14] = NVIC_INIT_ITNS14_VAL;
  #endif

  #if defined (NVIC_INIT_ITNS15) && (NVIC_INIT_ITNS15 == 1U)
    NVIC->ITNS[15] = NVIC_INIT_ITNS15_VAL;
  #endif

  /* repeat this for all possible ITNS elements */

}

#endif  /* PARTITION_ARMCM85_H */
