2950685798-cpu/GestureCar/(commit log)

2026-10-08 原地旋转时长改为2000ms
2026-10-08 原地旋转时长恢复为2500ms
