2950685798-cpu/GestureCar/(notices)

Notices in the files:
Car/Core/Src/main.c:
Copyright (c) 2026 STMicroelectronics.
All rights reserved.
This software is licensed under terms that can be found in the LICENSE file
